pchala/oximite/README.md

# oximite

**oximite** is an asynchronous Rust firmware for the RP2350 (Pimoroni Pico Plus 2 W), designed to retrofit standard domestic espresso machines (such as the Gaggia Classic) with advanced digital controls: dual PID loops (boiler temperature with real-time flow feed-forward, and unified pressure/flow pump profiling), and an embedded web dashboard.

Special thanks to [Pimoroni](https://pimoroni.com) for providing hardware.

Support development by [leaving a tip on Ko-fi](https://ko-fi.com/J5E121FXSB). 



## Getting started

- Repository layout, build, and test commands: [AGENTS.md](AGENTS.md).
- Documentation: [docs/](docs/). Start at [Requirements](docs/requirements.md).
- First-time setup: [Operations](docs/operations.md).

## Disclaimer

All hardware designs, code, and documentation are provided "AS IS", without warranty of any kind.
You are solely responsible for electrical and thermal safety when working with AC mains voltages and pressurized steam boilers.
