pchala/oximite/docs/hardware/mechanics.md

# Mechanics and hydraulic installation

This document describes mounting, enclosure constraints, and hydraulic sensor placement inside domestic espresso machines.

## 1. Electronics mounting and bracket

The controller board mounts inside the chassis using 3D-printable brackets:

- **Material:** PETG, ABS, or ASA. Do NOT use PLA due to elevated temperatures (~60–80 °C) inside the machine casing.
- **Placement:** Position the board in the lower or cooler quadrant of the machine (opposite the boiler exhaust). Ensure air gap from the boiler body.

## 2. Hydraulic sensor integration

```mermaid
flowchart TD
    RES[Water Reservoir] -->|Atmospheric silicone hose| FM[Hall flow meter: GP15]
    FM --> T_IN[Inlet T-fitting]
    T_IN -->|Suction line| PUMP[Vibration pump]
    PUMP --> T_OUT[Outlet T-fitting]
    T_OUT --> PT[Pressure transducer: GP40]
    T_OUT --> OPV[Over-Pressure Valve: OPV]
    OPV -.->|Recirculation bypass| T_IN
    OPV -->|Feed line| BOILER[Boiler & NTC: GP41]
    BOILER --> VALVE[3-way solenoid valve: GP3]
    VALVE -->|Brew path| GROUP[Grouphead / Portafilter puck]
    VALVE -->|Exhaust tube| DRIP[Drip tray]
```

### Flow meter placement

- **Inlet only:** The plastic flow meter (see [BOM](bom.md)) MUST be installed on the low-pressure suction side (between reservoir and pump inlet). Its plastic body cannot withstand pump pressure (up to 15 bar).
- **Air bubbles:** Mount horizontally with nozzle pointing down to prevent trapped air pockets that cause pulse jitter.
- **Recirculation:** The OPV bypass connects back to the pump inlet after the flow meter through an inlet T-fitting. Recirculated water does not affect water volume.

### Pressure transducer placement

- **High-pressure side:** Installed via a metal T-fitting between the pump outlet and the boiler.
- **Thread sealing:** Standard G1/8" thread sealed with food-grade high-temperature thread sealant or bonded copper washer.

## 3. Front panel switch layout

The machine front panel mounts two 3-position momentary mini toggle switches (spring return to center). The center position is off. Mount the power/steam switch on the left and the flush/brew switch on the right. [Hardware pinout](pinout.md) defines the GPIO and function of each switch position.
