pchala/oximite/docs/open-questions.md

# Open questions

This is the single open-question list for the complete system. Use it for project review.

Add each new unresolved question here. Do not keep open-question lists in requirement, design, interface, or component documents. Remove a question only after a requirement or an accepted decision resolves it.

There are currently no open questions.
