pchala/oximite/pcb/oximite.kicad_pcb

## KiCad design pcb/oximite.kicad_pcb (2026-10-21)

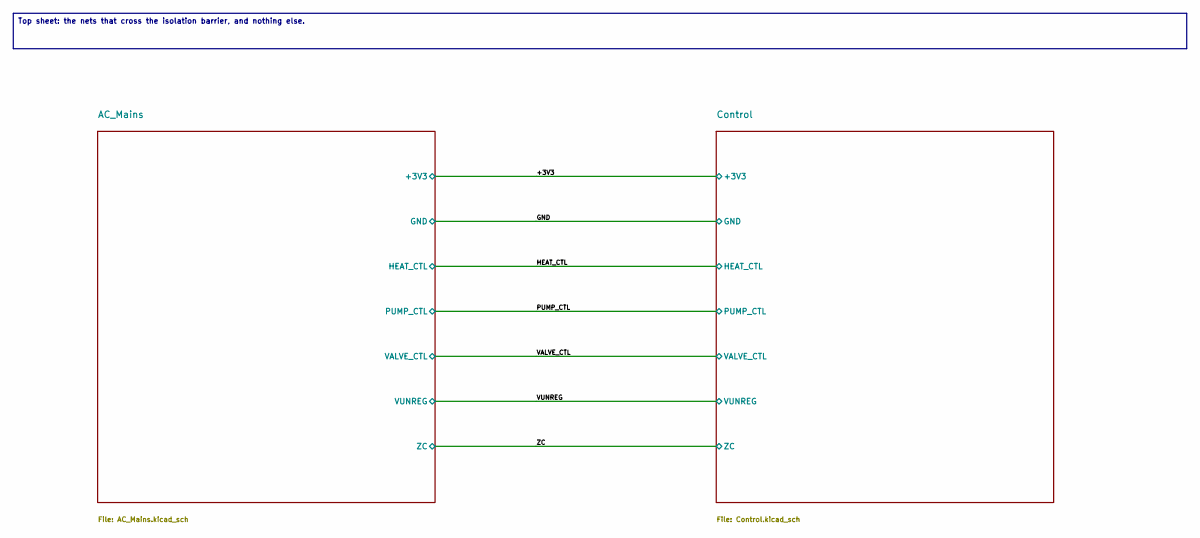
[picture p1: schematic oximite.kicad_sch]

Notes on the sheet:
Top sheet: the nets that cross the isolation barrier, and nothing else.

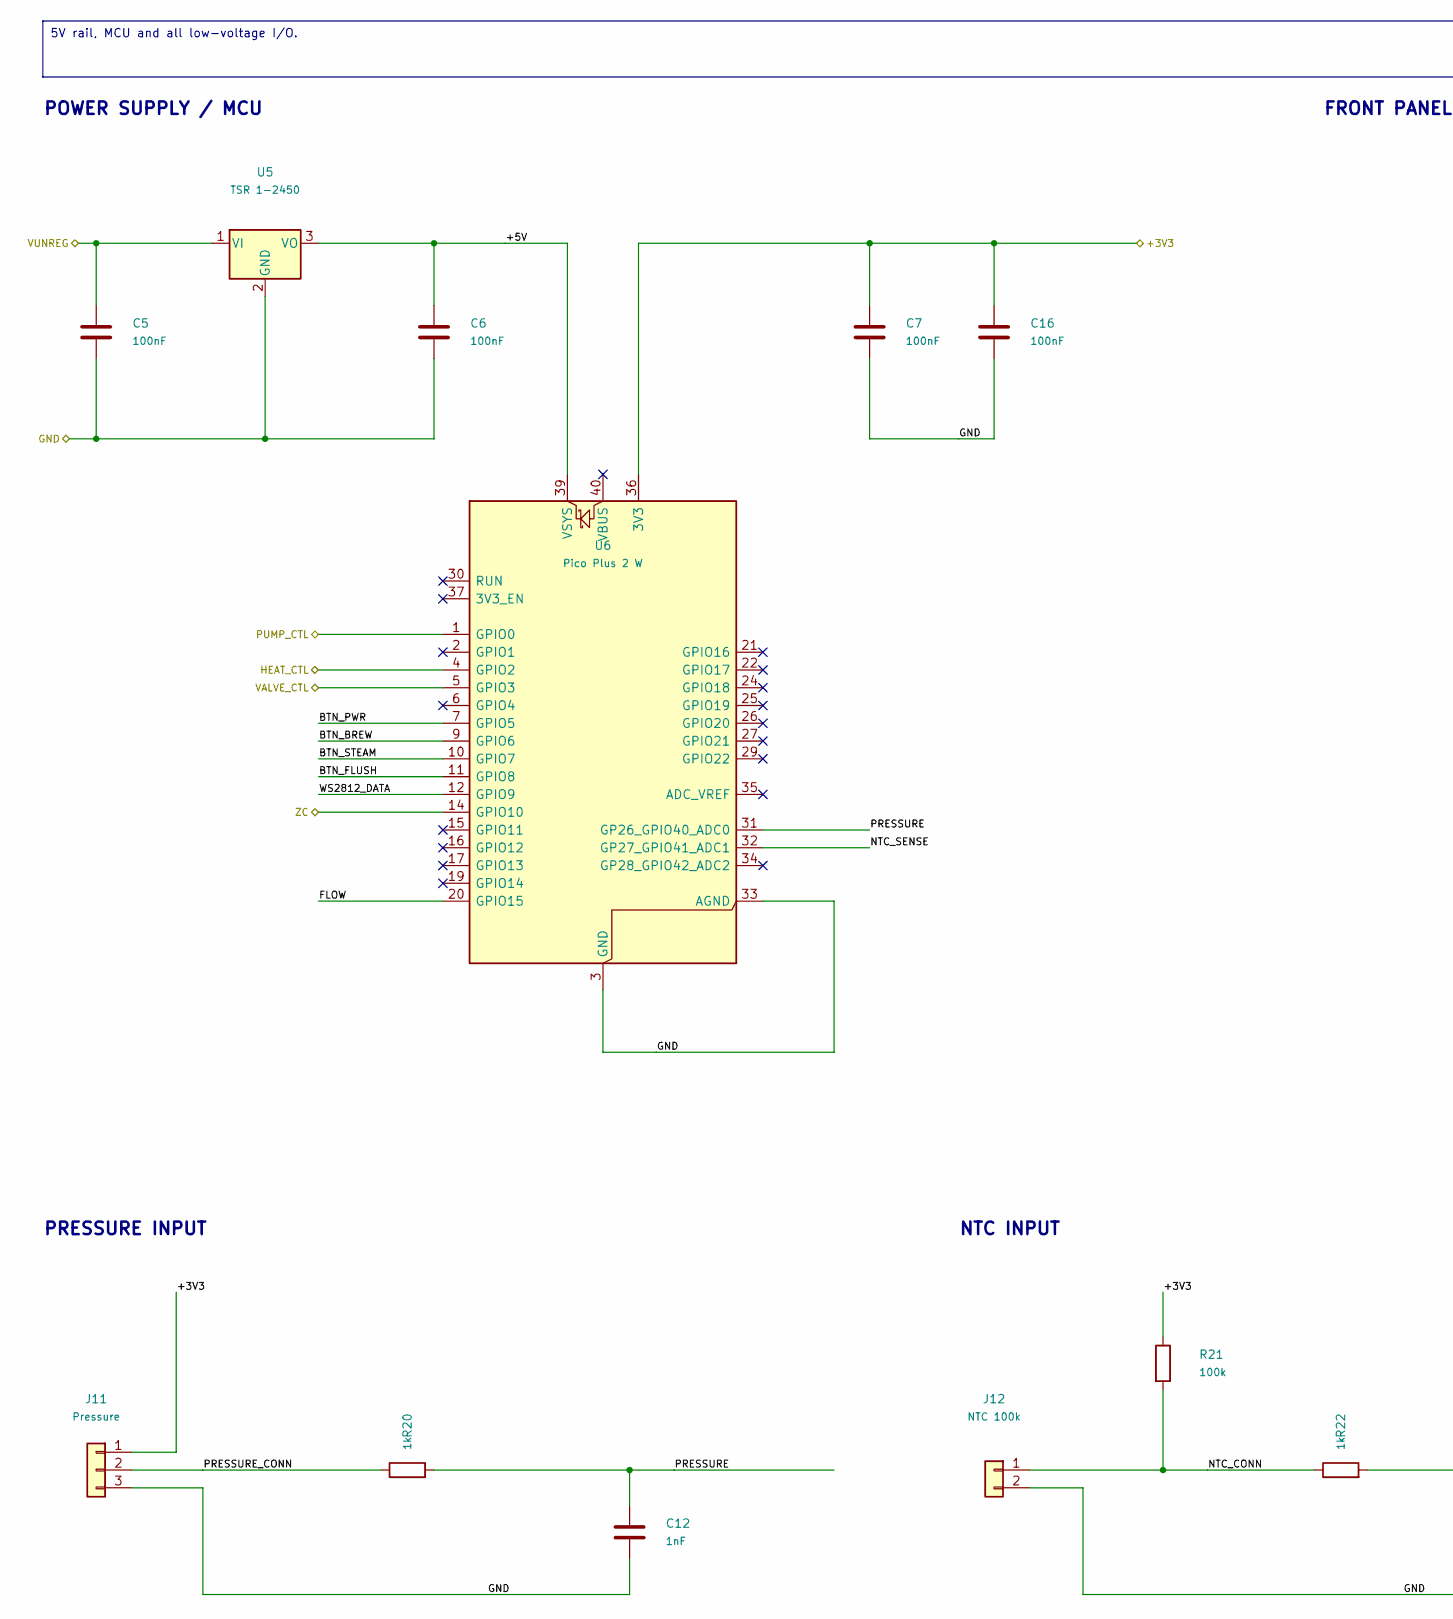
[picture p2: schematic Control.kicad_sch, oximite, part in row 1, column 1]

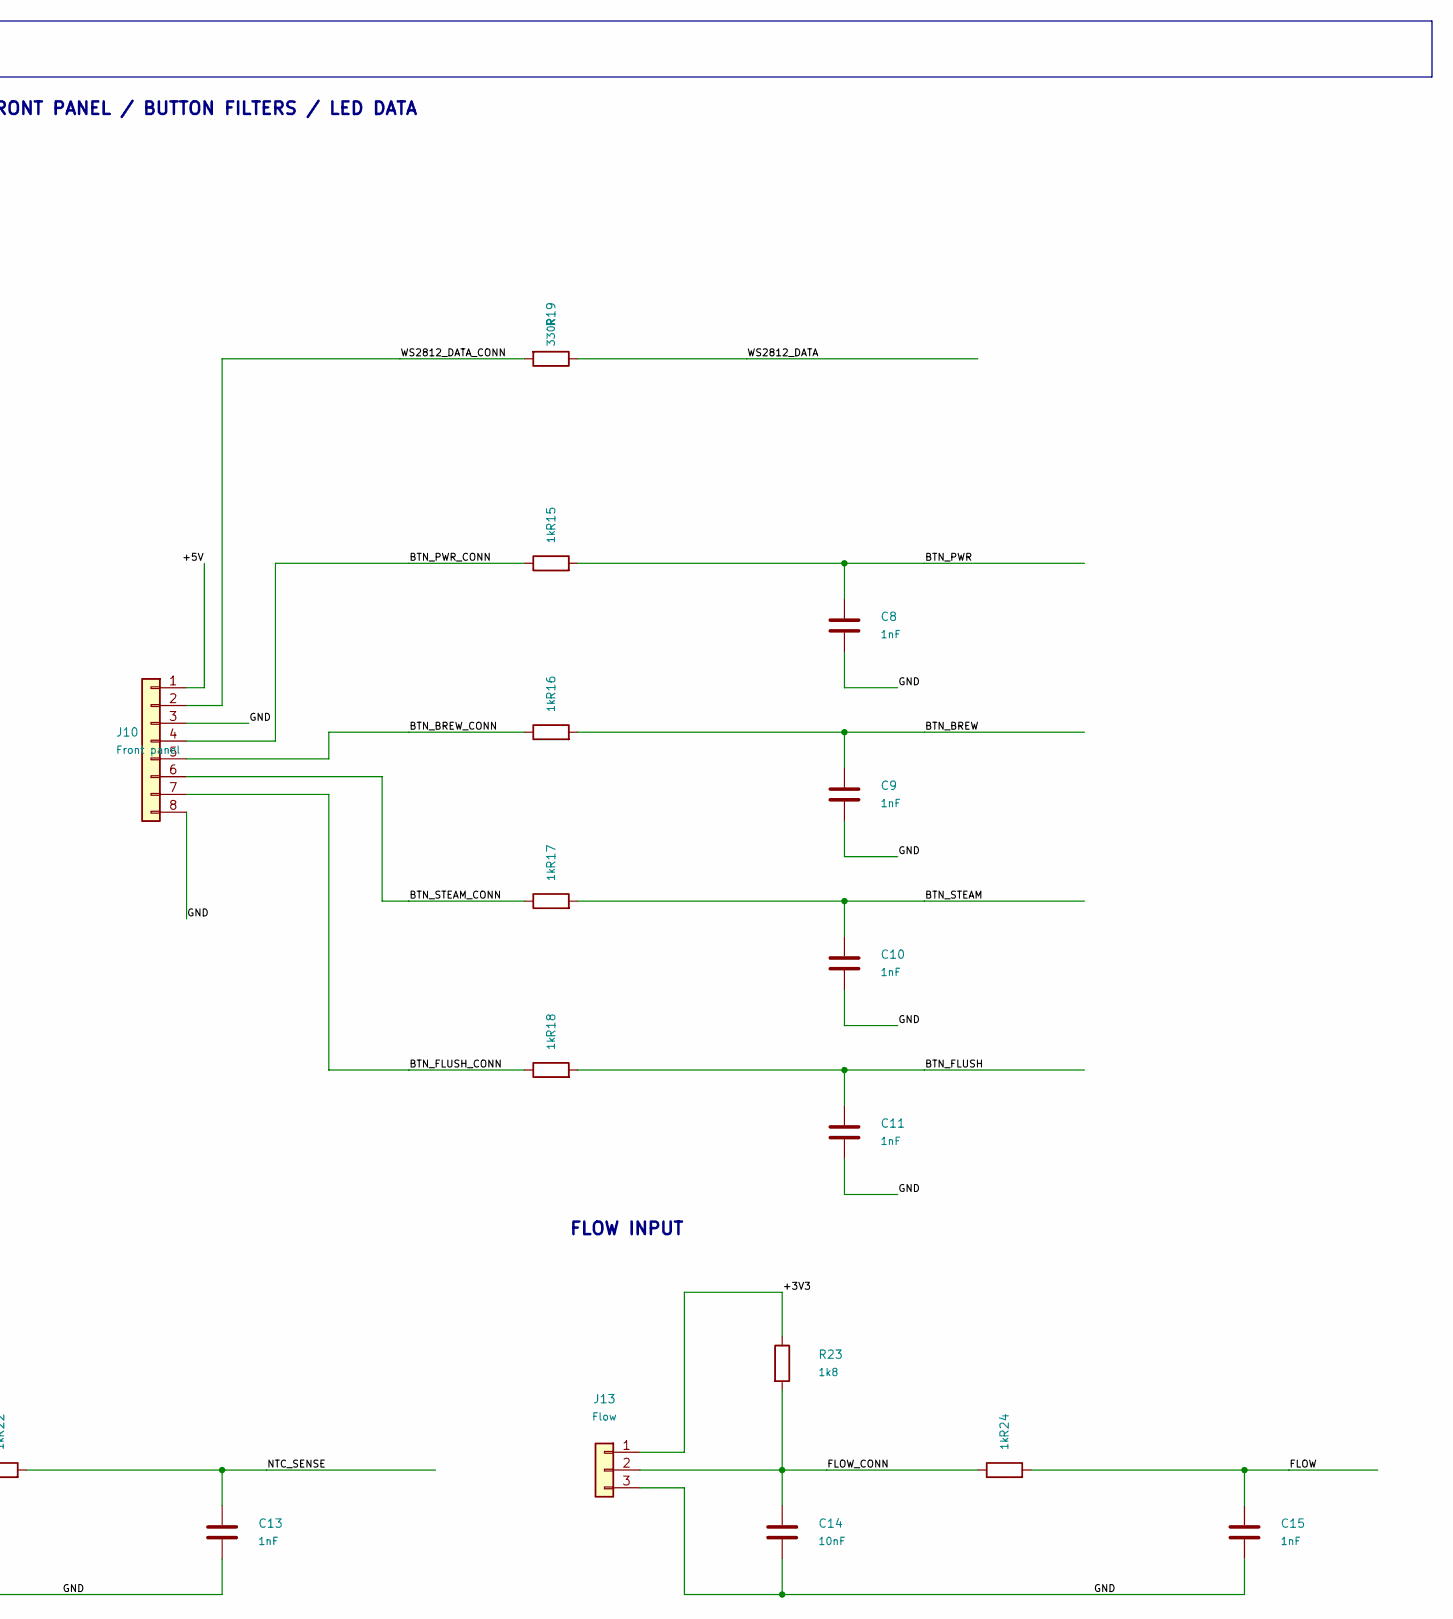
[picture p3: schematic Control.kicad_sch, oximite, part in row 1, column 2]

Parts:
C5, C6, C7, C16: 100nF; C_0603_1608Metric
C8, C9, C10, C11, C12, C13, C15: 1nF; C_0603_1608Metric
C14: 10nF; C_0603_1608Metric
J10: Front panel; JST_XH_B8B-XH-A_1x08_P2.50mm_Vertical
J11: Pressure; JST_XH_B3B-XH-A_1x03_P2.50mm_Vertical
J12: NTC 100k; JST_XH_B2B-XH-A_1x02_P2.50mm_Vertical
J13: Flow; JST_XH_B3B-XH-A_1x03_P2.50mm_Vertical
R15, R16, R17, R18, R20, R22, R24: 1k; R_0603_1608Metric
R19: 330R; R_0603_1608Metric
R21: 100k; R_0603_1608Metric
R23: 1k8; R_0603_1608Metric
U5: TSR 1-2450; Converter_DCDC_TRACO_TSR-1_THT
U6: Pico Plus 2 W; Pimoroni_Pico_Plus_2_W_Header_Mount

Connections:
/+3V3: C7.1, C16.1, J11.1, J13.1, R21.1, R23.1, U6.36 (3V3); also elsewhere on the board
/Control/+5V: C6.1, J10.1, U5.3 (VO), U6.39 (VSYS)
/Control/BTN_BREW: C9.1, R16.2, U6.9 (GPIO6)
/Control/BTN_BREW_CONN: J10.5, R16.1
/Control/BTN_FLUSH: C11.1, R18.2, U6.11 (GPIO8)
/Control/BTN_FLUSH_CONN: J10.7, R18.1
/Control/BTN_PWR: C8.1, R15.2, U6.7 (GPIO5)
/Control/BTN_PWR_CONN: J10.4, R15.1
/Control/BTN_STEAM: C10.1, R17.2, U6.10 (GPIO7)
/Control/BTN_STEAM_CONN: J10.6, R17.1
/Control/FLOW: C15.1, R24.2, U6.20 (GPIO15)
/Control/FLOW_CONN: C14.1, J13.2, R23.2, R24.1
/Control/NTC_CONN: J12.1, R21.2, R22.1
/Control/NTC_SENSE: C13.1, R22.2, U6.32 (GP27_GPIO41_ADC1)
/Control/PRESSURE: C12.1, R20.2, U6.31 (GP26_GPIO40_ADC0)
/Control/PRESSURE_CONN: J11.2, R20.1
/Control/WS2812_DATA: R19.1, U6.12 (GPIO9)
/Control/WS2812_DATA_CONN: J10.2, R19.2
/GND: C5.2, C6.2, C7.2, C8.2, C9.2, C10.2, C11.2, C12.2, C13.2, C14.2, C15.2, C16.2, J10.3, J10.8, J11.3, J12.2, J13.3, U5.2 (GND), U6.3 (GND), U6.8 (GND), U6.13 (GND), U6.18 (GND), U6.23 (GND), U6.28 (GND), U6.33 (AGND), U6.38 (GND); also elsewhere on the board
/HEAT_CTL: U6.4 (GPIO2); also elsewhere on the board
/PUMP_CTL: U6.1 (GPIO0); also elsewhere on the board
/VALVE_CTL: U6.5 (GPIO3); also elsewhere on the board
/VUNREG: C5.1, U5.1 (VI); also elsewhere on the board
/ZC: U6.14 (GPIO10); also elsewhere on the board

Notes on the sheet:
5V rail, MCU and all low-voltage I/O.
POWER SUPPLY / MCU
FRONT PANEL / BUTTON FILTERS / LED DATA
PRESSURE INPUT
NTC INPUT
FLOW INPUT

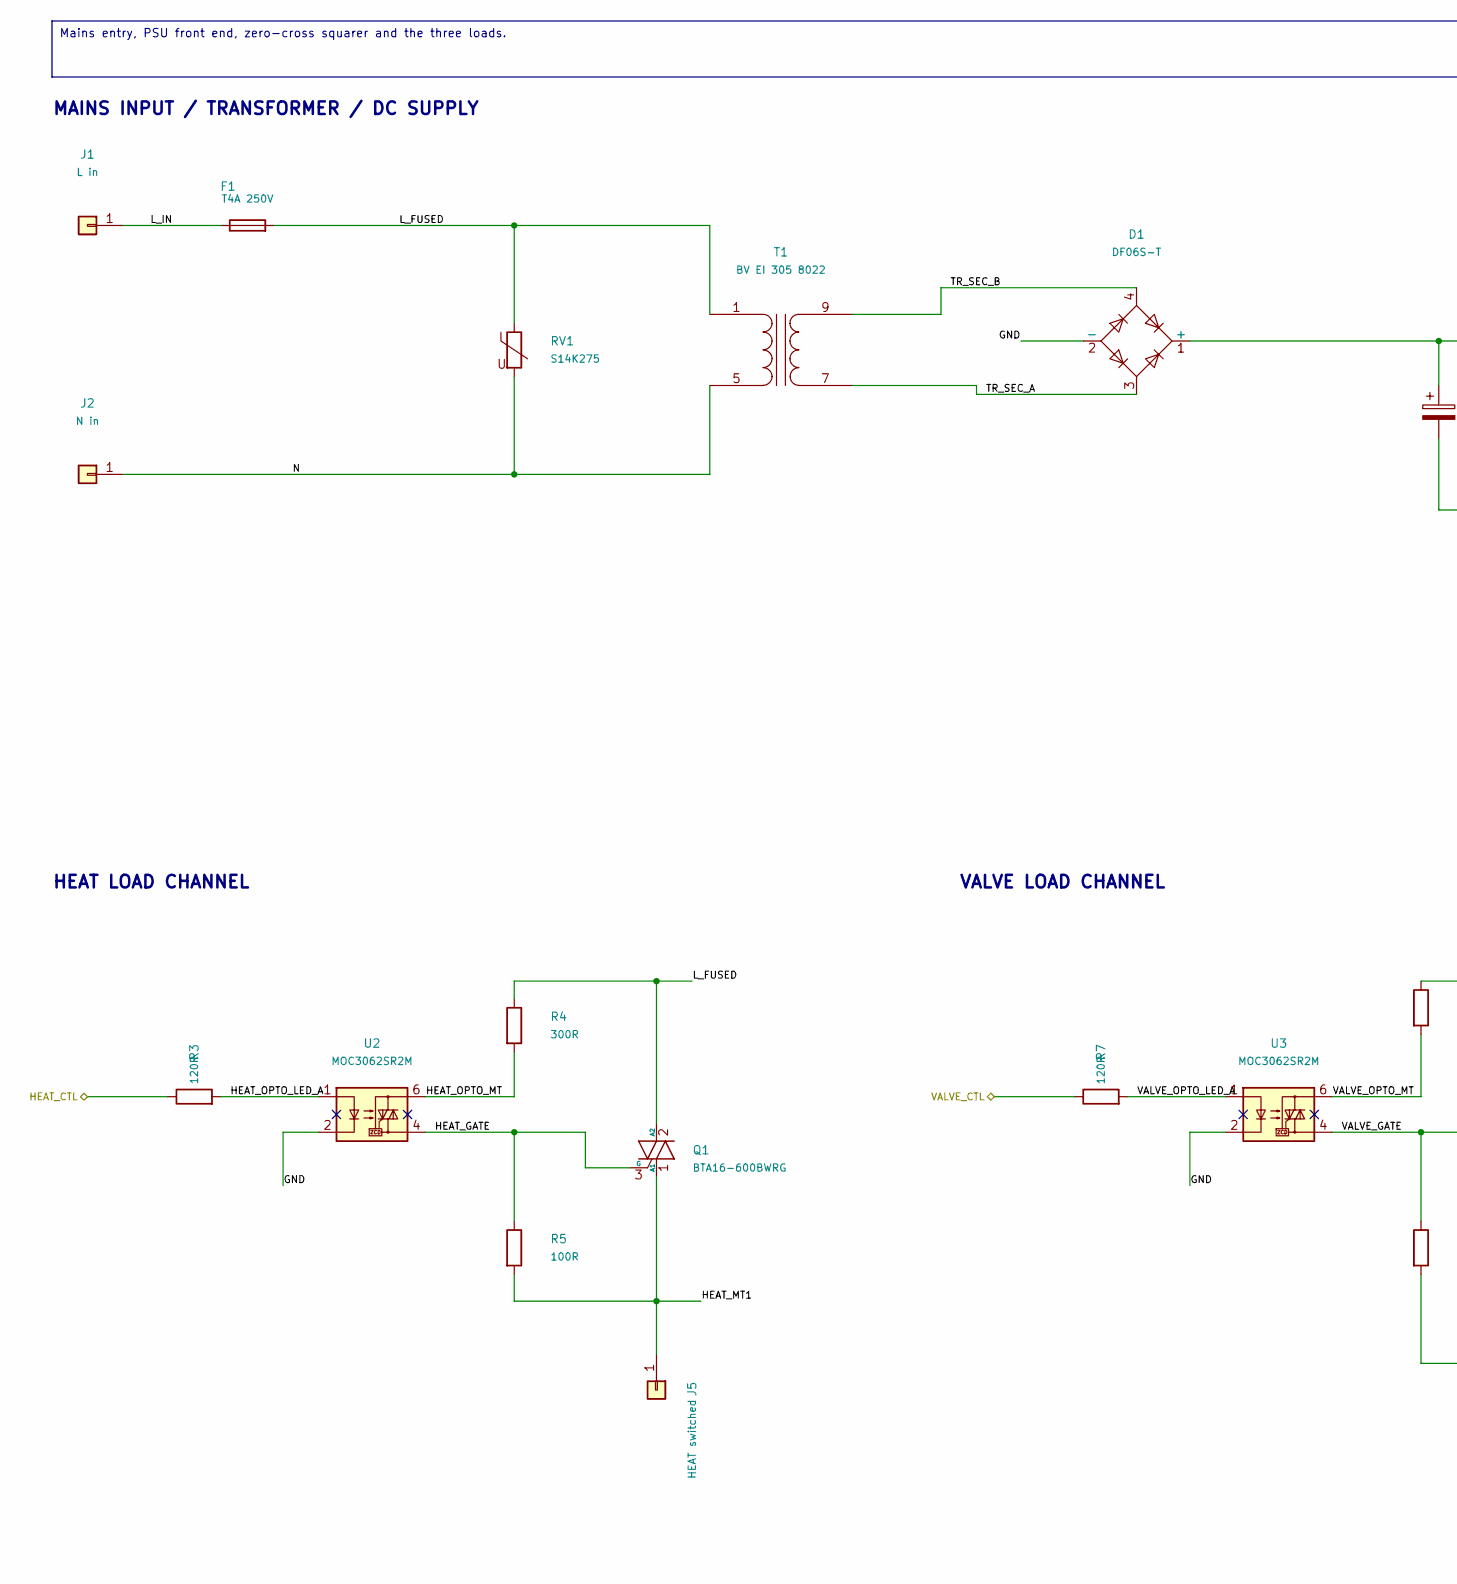
[picture p4: schematic AC_Mains.kicad_sch, oximite, part in row 1, column 1]

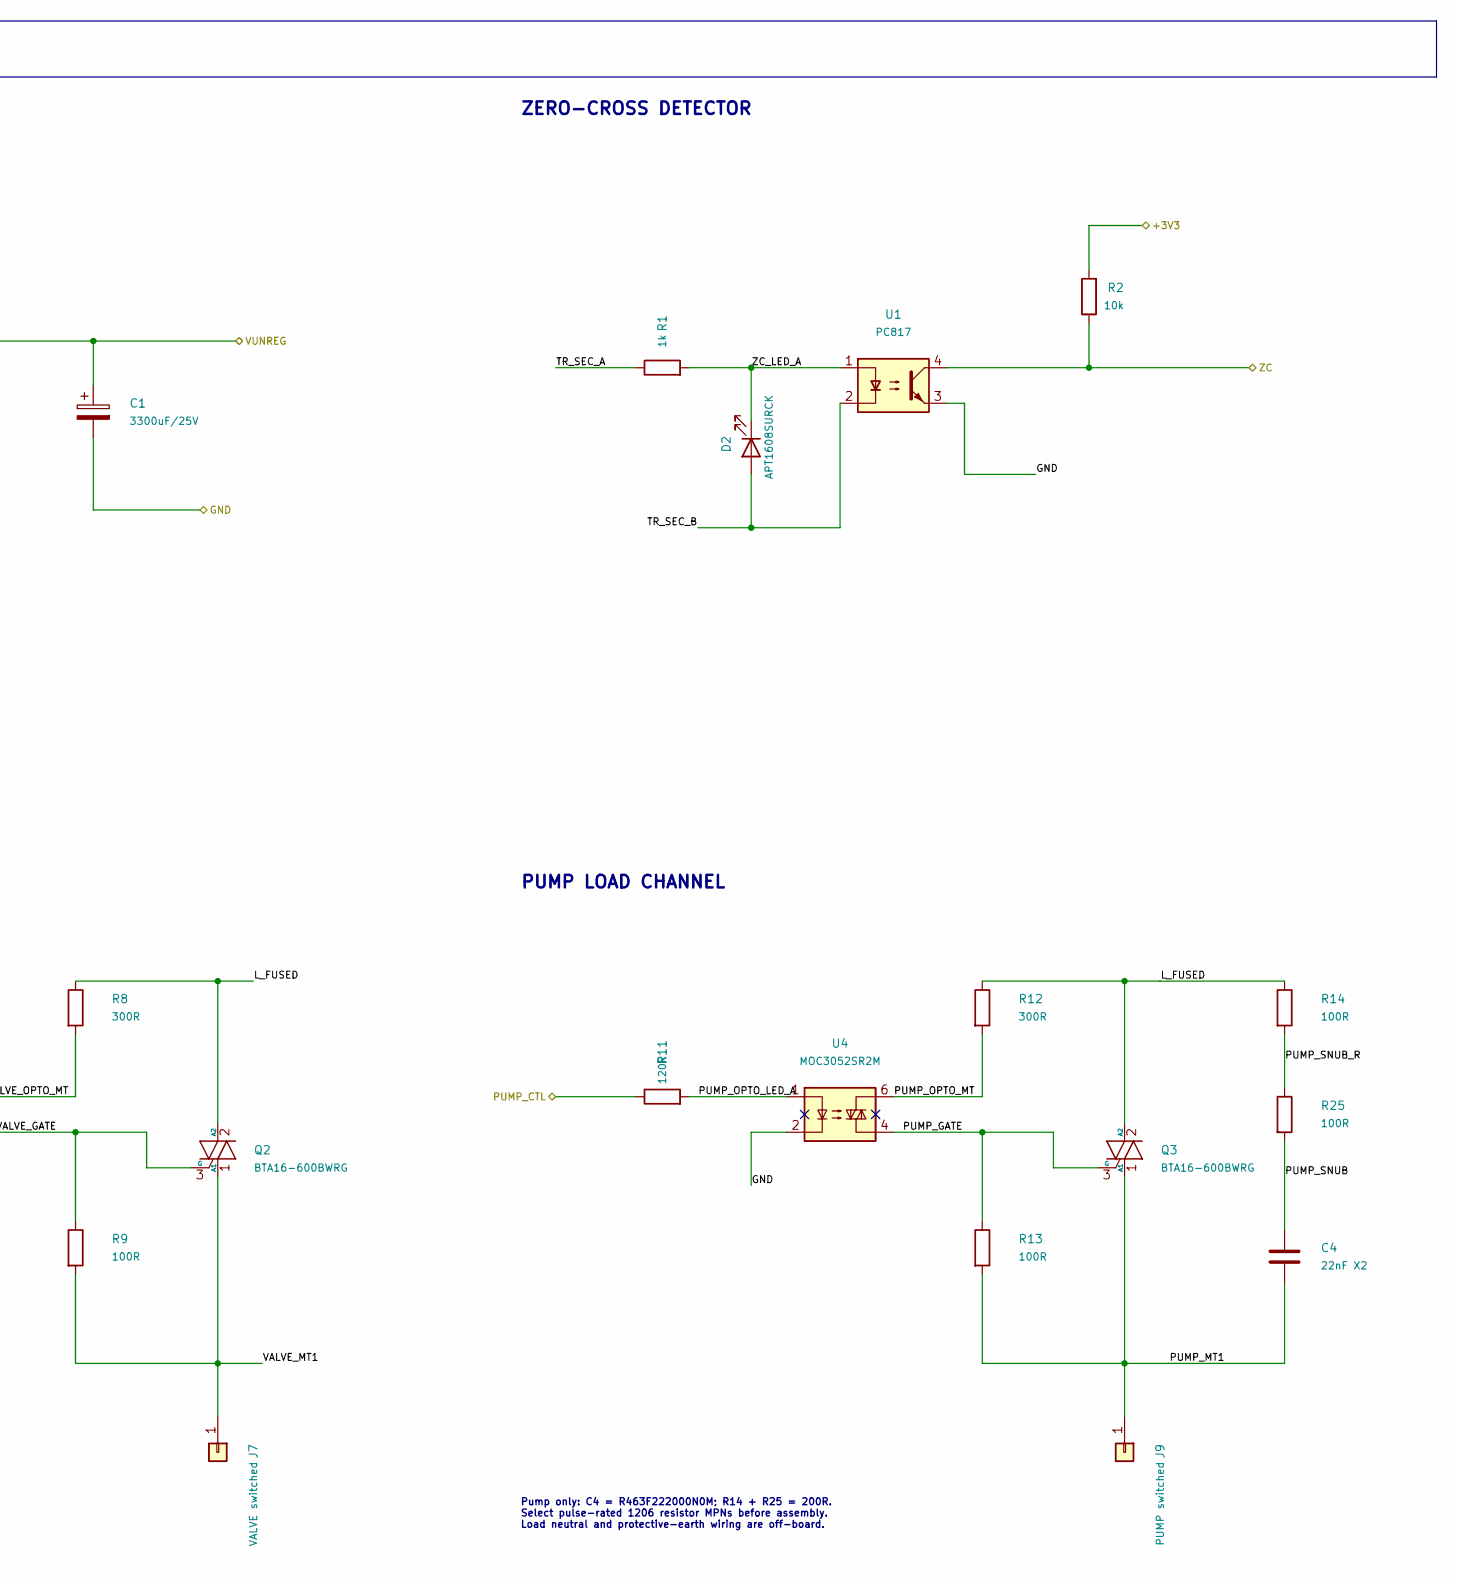
[picture p5: schematic AC_Mains.kicad_sch, oximite, part in row 1, column 2]

Parts:
C1: 3300uF/25V; CP_Radial_D12.5mm_P5.00mm
C4: 22nF X2; C_Rect_L13.0mm_W4.0mm_P10.00mm_FKS3_FKP3_MKS4
D1: DF06S-T; Diode_Bridge_OnSemi_SDIP-4L
D2: APT1608SURCK; LED_0603_1608Metric
F1: T4A 250V; Fuseholder_Clip-5x20mm_Keystone_3517_Inline_P23.11x6.76mm_D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
J1: L in; Spade_6.35mm_Keystone_1287
J2: N in; Spade_6.35mm_Keystone_1287
J5: HEAT switched; Spade_6.35mm_Keystone_1287
J7: VALVE switched; Spade_6.35mm_Keystone_1287
J9: PUMP switched; Spade_6.35mm_Keystone_1287
Q1, Q2, Q3: BTA16-600BWRG; TO-220-3_Vertical
R1: 1k; R_1206_3216Metric
R2: 10k; R_0603_1608Metric
R3, R7, R11: 120R; R_0805_2012Metric
R4, R8, R12: 300R; R_1206_3216Metric
R5, R9, R13, R14, R25: 100R; R_1206_3216Metric
RV1: S14K275; RV_Disc_D16.5mm_W6.7mm_P7.5mm
T1: BV EI 305 8022; Transformer_Hahn_BV_EI_305
U1: PC817; SOP-4_4.4x2.6mm_P1.27mm
U2, U3: MOC3062SR2M; SMDIP-6_W9.53mm_Clearance8mm
U4: MOC3052SR2M; SMDIP-6_W9.53mm_Clearance8mm

Connections:
/+3V3: R2.2; also elsewhere on the board
/AC_Mains/HEAT_GATE: Q1.3 (G), R5.1, U2.4
/AC_Mains/HEAT_MT1: J5.1, Q1.1 (A1), R5.2
/AC_Mains/HEAT_OPTO_LED_A: R3.2, U2.1
/AC_Mains/HEAT_OPTO_MT: R4.2, U2.6
/AC_Mains/L_FUSED: F1.2, Q1.2 (A2), Q2.2 (A2), Q3.2 (A2), R4.1, R8.1, R12.1, R14.1, RV1.1, T1.1
/AC_Mains/L_IN: F1.1, J1.1
/AC_Mains/N: J2.1, RV1.2, T1.5 (P2)
/AC_Mains/PUMP_GATE: Q3.3 (G), R13.1, U4.4
/AC_Mains/PUMP_MT1: C4.2, J9.1, Q3.1 (A1), R13.2
/AC_Mains/PUMP_OPTO_LED_A: R11.2, U4.1
/AC_Mains/PUMP_OPTO_MT: R12.2, U4.6
/AC_Mains/PUMP_SNUB: C4.1, R25.2
/AC_Mains/PUMP_SNUB_R: R14.2, R25.1
/AC_Mains/TR_SEC_A: D1.3, R1.1, T1.7 (S1)
/AC_Mains/TR_SEC_B: D1.4, D2.2 (A), T1.9 (S2), U1.2
/AC_Mains/VALVE_GATE: Q2.3 (G), R9.1, U3.4
/AC_Mains/VALVE_MT1: J7.1, Q2.1 (A1), R9.2
/AC_Mains/VALVE_OPTO_LED_A: R7.2, U3.1
/AC_Mains/VALVE_OPTO_MT: R8.2, U3.6
/AC_Mains/ZC_LED_A: D2.1 (K), R1.2, U1.1
/GND: C1.2, D1.2 (-), U1.3, U2.2, U3.2, U4.2; also elsewhere on the board
/HEAT_CTL: R3.1; also elsewhere on the board
/PUMP_CTL: R11.1; also elsewhere on the board
/VALVE_CTL: R7.1; also elsewhere on the board
/VUNREG: C1.1, D1.1 (+); also elsewhere on the board
/ZC: R2.1, U1.4; also elsewhere on the board

Notes on the sheet:
VALVE LOAD CHANNEL
PUMP LOAD CHANNEL
HEAT LOAD CHANNEL
MAINS INPUT / TRANSFORMER / DC SUPPLY
ZERO-CROSS DETECTOR
Mains entry, PSU front end, zero-cross squarer and the three loads.
Pump only: C4 = R463F222000N0M; R14 + R25 = 200R. Select pulse-rated 1206 resistor MPNs before assembly. Load neutral and protective-earth wiring are off-board.

Board: 2 copper layers, 64 parts (1 on the bottom side), 44 nets, no tracks yet.

Other parts of the board:
H1, H2, H3, H4: M3 corner mounting; MountingHole_3.2mm_M3
