pchala/oximite/src/state.rs

use core::cell::Cell;
use core::sync::atomic::Ordering;
use embassy_sync::blocking_mutex::raw::CriticalSectionRawMutex;
use embassy_sync::blocking_mutex::Mutex as BlockingMutex;
use embassy_sync::channel::Channel;
use embassy_sync::watch::Watch;
use num_enum::{IntoPrimitive, TryFromPrimitive};
use portable_atomic::{AtomicU32, AtomicU8};

/// Discriminants are a wire contract with the web UI: `web_api` sends the raw
/// value as telemetry `st`, and `index.html` indexes a positional name array
/// with it. The HTML is gzipped into the firmware by `build.rs` and the value
/// is never persisted to flash, so the two always ship together — but renumber
/// both sides in the same commit.
#[repr(u8)]
#[derive(Clone, Copy, PartialEq, defmt::Format, IntoPrimitive, TryFromPrimitive)]
pub enum MachineState {
    Idle = 0,
    Brewing = 1,
    Steaming = 2,
    Sleeping = 3,
    Pumping = 4,
    Cooling = 5,
    HotWater = 6,
}

impl MachineState {
    /// States representing an active hardware operation (profile/steam/pump
    /// running). The coordinator treats this as "an operation is in flight",
    /// so any command that isn't one of `Steaming`'s two onward transitions
    /// stops the machine. Update this in one place when adding new states.
    pub fn is_busy(self) -> bool {
        matches!(
            self,
            MachineState::Brewing
                | MachineState::Pumping
                | MachineState::Cooling
                | MachineState::HotWater
                | MachineState::Steaming
        )
    }
}

#[derive(Clone)]
#[allow(clippy::large_enum_variant)]
pub enum MachineCommand {
    RunProfile(crate::profiles::BrewProfile),
    Brew,
    Stop,
    Steam,
    Flush,
    DirectPump(f32),
    SaveMachine(crate::settings::MachineSettings),
    SavePids(crate::settings::PidSettings, crate::settings::PidSettings),
    SaveWifi(crate::settings::WifiSettings),
    /// Store a profile in `slot`, mirroring it to flash. Routed through the
    /// coordinator rather than signalled straight to the flash task so it is
    /// held back during a shot like every other flash write.
    SaveProfile(u8, crate::profiles::BrewProfile),
    DeleteProfile(u8),
    TogglePower,
    SetSessionTemp(f32),
}

/// How the coordinator should treat a command before the state machine sees
/// it. See [`MachineCommand::ambient`].
#[derive(PartialEq, Eq, Clone, Copy)]
pub enum Ambient {
    /// Carries a machine action: goes to the transition table.
    No,
    /// Applies immediately in any state, touching RAM only.
    RamOnly,
    RamAndFlash,
}

impl MachineCommand {
    /// Whether this command bypasses the state machine, and if so whether it
    /// reaches flash.
    pub fn ambient(&self) -> Ambient {
        match self {
            MachineCommand::SaveMachine(_)
            | MachineCommand::SavePids(_, _)
            | MachineCommand::SaveWifi(_)
            | MachineCommand::SaveProfile(_, _)
            | MachineCommand::DeleteProfile(_) => Ambient::RamAndFlash,

            MachineCommand::SetSessionTemp(_) => Ambient::RamOnly,

            MachineCommand::RunProfile(_)
            | MachineCommand::Brew
            | MachineCommand::Stop
            | MachineCommand::Steam
            | MachineCommand::Flush
            | MachineCommand::DirectPump(_)
            | MachineCommand::TogglePower => Ambient::No,
        }
    }
}

impl defmt::Format for MachineCommand {
    fn format(&self, fmt: defmt::Formatter) {
        match self {
            MachineCommand::RunProfile(_) => defmt::write!(fmt, "RunProfile"),
            MachineCommand::Brew => defmt::write!(fmt, "Brew"),
            MachineCommand::Stop => defmt::write!(fmt, "Stop"),
            MachineCommand::Steam => defmt::write!(fmt, "Steam"),
            MachineCommand::Flush => defmt::write!(fmt, "Flush"),
            MachineCommand::DirectPump(p) => defmt::write!(fmt, "DirectPump({})", p),
            MachineCommand::SaveMachine(_) => defmt::write!(fmt, "SaveMachine"),
            MachineCommand::SavePids(_, _) => defmt::write!(fmt, "SavePids"),
            MachineCommand::SaveWifi(_) => defmt::write!(fmt, "SaveWifi"),
            MachineCommand::SaveProfile(slot, _) => defmt::write!(fmt, "SaveProfile({})", slot),
            MachineCommand::DeleteProfile(slot) => defmt::write!(fmt, "DeleteProfile({})", slot),
            MachineCommand::TogglePower => defmt::write!(fmt, "TogglePower"),
            MachineCommand::SetSessionTemp(t) => defmt::write!(fmt, "SetSessionTemp({})", t),
        }
    }
}

/// Commands headed for `coordinator::coordinator_task`.
///
/// This is a queue, not a `Signal`, because it has several independent
/// producers — the button task on core0 and the web API on core1 — and every
/// one of their commands means something different. A `Signal` holds a single
/// slot and overwrites it, so two commands issued before the coordinator was
/// scheduled would silently collapse into one, and a genuinely concurrent
/// core1 request could destroy a button press outright. Ordering matters too:
/// a `Stop` followed by a start command must arrive as two separate events.
///
/// Depth 4 covers the realistic worst case — all four buttons resolving in one
/// debounce pass — without spending much RAM on the large `RunProfile` variant.
static COMMAND_QUEUE: Channel<CriticalSectionRawMutex, MachineCommand, 4> = Channel::new();

/// Next ack ticket.
///
/// Bumped inside the same critical section as the push because tickets are only
/// meaningful in queue order, and both cores produce commands: the button task
/// on core0 and the web tasks on core1.
static NEXT_TICKET: BlockingMutex<CriticalSectionRawMutex, Cell<u32>> =
    BlockingMutex::new(Cell::new(0));

/// Commands the coordinator has finished serving. Tickets start at 1, so 0
/// means nothing has been served yet and ticket N is applied once this reaches N.
static SERVED: AtomicU32 = AtomicU32::new(0);

/// Queues a command, returning its ack ticket, or `None` if the queue is full.
///
/// Non-blocking, because the callers are the button poller and HTTP request
/// handlers and neither may stall on the coordinator. The ticket is what makes
/// that safe: a caller who needs to know the command was acted on watches
/// [`get_ack`] reach it, and a `None` means the command never made it.
#[must_use = "a dropped ticket cannot be confirmed; use `let _ =` if the caller does not need one"]
pub fn send_command(cmd: MachineCommand) -> Option<u32> {
    NEXT_TICKET.lock(|t| {
        if COMMAND_QUEUE.try_send(cmd).is_err() {
            defmt::warn!("Command queue full — command dropped");
            return None;
        }
        let ticket = t.get().wrapping_add(1);
        t.set(ticket);
        Some(ticket)
    })
}

/// Records that the coordinator finished serving one command. Coordinator only.
pub fn mark_served() {
    SERVED.fetch_add(1, Ordering::Relaxed);
}

/// Highest ticket the coordinator has served.
pub fn get_ack() -> u32 {
    SERVED.load(Ordering::Relaxed)
}

/// Waits for the next queued command. Single-consumer: only the coordinator
/// calls this.
pub async fn next_command() -> MachineCommand {
    COMMAND_QUEUE.receive().await
}

/// Filtered analog readings, published by `adc::adc_task`.
#[derive(Clone, Copy)]
pub struct SensorReading {
    pub pressure_bar: f32,
    pub temp_c: f32,
}

impl Default for SensorReading {
    fn default() -> Self {
        // Not derived: a 0 °C boiler is a huge error to the temperature PID,
        // and this default is what the control loop reads on the first ticks
        // after boot, before the ADC has published anything.
        Self {
            pressure_bar: 0.0,
            temp_c: 20.0,
        }
    }
}

pub static SENSOR_WATCH: Watch<CriticalSectionRawMutex, SensorReading, 4> = Watch::new();

/// The latest filtered sensor reading, or a plausible cold-machine reading if
/// the ADC has not published yet.
pub fn get_sensors() -> SensorReading {
    SENSOR_WATCH.try_get().unwrap_or_default()
}

/// Everything the UI and the LED task need to render the machine, published
/// as one snapshot by `control::ac_sync_control_task`, once per 50 Hz control
/// tick. Single producer: the measured values are copied in from
/// `SENSOR_WATCH` rather than written by the ADC task directly, so every field
/// in a given snapshot describes the same tick.
#[derive(Clone, Copy, Default)]
pub struct Telemetry {
    /// Control-loop tick this snapshot describes. Lets a consumer tell a
    /// duplicate sample from a fresh one, and count frames it never saw.
    pub tick: u32,
    pub pressure_bar: f32,
    pub temp_c: f32,
    /// Setpoint the profile asked for, 0 when the step names no pressure
    /// target.
    pub target_bar: f32,
    pub target_temp: f32,
    /// `target_temp` plus the brew-flow feed-forward — what the temperature PID
    /// actually chased. Diverges from `target_temp` by several degrees during a
    /// shot, which otherwise reads as unexplained overshoot.
    pub effective_target_temp: f32,
    pub target_ml_s: f32,
    /// Flow reading the controller acted on this tick. Carried here so a log
    /// row is one coherent snapshot; the web task runs on the other core and
    /// would otherwise sample flow at a different instant than pressure.
    pub flow_rate_ml_s: f32,
    /// Shot volume as of this tick, for the same reason.
    pub volume_ml: f32,
    /// True while the flow channel is the binding constraint on the pump — the
    /// unified controller picked flow over pressure. Without it a log can't
    /// tell a flow-controlled step from a pressure step that happens to be
    /// flowing.
    pub flow_controlled: bool,
    pub heater_duty: f32,
    /// Triac duty the pump was driven at this tick, 0-100.
    pub pump_duty: f32,
}

impl Telemetry {
    /// Group-head temperature for display: the measured boiler value with the
    /// boiler-to-group offset subtracted, except while steaming, where the
    /// boiler value *is* what the UI shows.
    pub fn display_temp(&self, offset: f32, is_steaming: bool) -> f32 {
        if is_steaming {
            self.temp_c
        } else {
            self.temp_c - offset
        }
    }
}

pub static TELEMETRY_WATCH: Watch<CriticalSectionRawMutex, Telemetry, 4> = Watch::new();

/// The latest telemetry snapshot, or a plausible cold-machine reading if no
/// producer has published yet — callers would otherwise see a 0 °C boiler for
/// the first few milliseconds after boot and act on it.
pub fn get_telemetry() -> Telemetry {
    TELEMETRY_WATCH.try_get().unwrap_or(Telemetry {
        temp_c: 20.0,
        target_temp: 20.0,
        effective_target_temp: 20.0,
        ..Default::default()
    })
}

// The Watch channel acts as our centralized, broadcasted state for tasks that want notifications.
pub static MACHINE_STATE: Watch<CriticalSectionRawMutex, MachineState, 4> = Watch::new();
static CURRENT_STATE: AtomicU8 = AtomicU8::new(MachineState::Idle as u8);

pub fn get_state() -> MachineState {
    // The raw value is only ever written via set_state(), so it always
    // matches a valid discriminant; Idle is a safe fallback regardless.
    MachineState::try_from_primitive(CURRENT_STATE.load(Ordering::Relaxed))
        .unwrap_or(MachineState::Idle)
}

pub fn set_state(state: MachineState) {
    let old_state = get_state();
    if old_state != state {
        defmt::info!("State Change: {:?} -> {:?}", old_state, state);
        CURRENT_STATE.store(state.into(), Ordering::Relaxed);
        MACHINE_STATE.sender().send(state);
    }
}

static SESSION_BREW_TEMP: AtomicU32 = AtomicU32::new(0);

pub fn get_session_brew_temp() -> f32 {
    f32::from_bits(SESSION_BREW_TEMP.load(Ordering::Relaxed))
}

pub fn set_session_brew_temp(temp: f32) {
    SESSION_BREW_TEMP.store(temp.to_bits(), Ordering::Relaxed);
}
