pchala/oximite/src/adc.rs

//! Analog sensor acquisition: oversamples the pressure and boiler-temperature
//! channels, filters them, converts to physical units, and publishes the
//! result into `state::SENSOR_WATCH` for every other task to read.

use embassy_rp::adc::{Adc, Async, Channel};
use embassy_time::Duration;

use crate::state::{SensorReading, SENSOR_WATCH};

/// Conversions taken per channel per cycle, and how many of the trailing ones
/// are averaged. The leading `SAMPLE_TOTAL - SAMPLE_KEEP` are thrown away to
/// let the sample-and-hold capacitor settle.
const SAMPLE_TOTAL: usize = 10;
const SAMPLE_KEEP: usize = 5;

/// Raw ADC counts to boiler temperature in °C, by linear interpolation between
/// the two `NTC_LUT` entries that bracket the reading.
fn get_temp_from_adc(raw_adc: f32) -> f32 {
    let index_f = raw_adc.clamp(0.0, 4095.0) / 4.0;
    let index = index_f as usize;

    if index >= 1024 {
        return NTC_LUT[1024];
    }

    let remainder = index_f - (index as f32);
    let lower = NTC_LUT[index];
    let upper = NTC_LUT[index + 1];
    lower + (upper - lower) * remainder
}

/// Raw ADC counts to gauge pressure in bar. The transducer outputs 0.4 V at
/// 0 MPa and 2.4 V at 1.2 MPa (12 bar), i.e. 6 bar per volt above a 0.4 V
/// offset. Clamped at zero so sensor noise around ambient can't read negative.
fn get_pressure_from_adc(raw_adc: f32) -> f32 {
    const ADC_TO_VOLTS: f32 = 3.3 / 4095.0;
    const V_AT_ZERO_BAR: f32 = 0.4;
    const BAR_PER_VOLT: f32 = 12.0 / 2.0;
    ((raw_adc * ADC_TO_VOLTS - V_AT_ZERO_BAR) * BAR_PER_VOLT).max(0.0)
}

/// Samples `SAMPLE_TOTAL` conversions from `ch`, discarding the leading ones
/// (letting the sample-and-hold cap settle) and returning the average of the
/// last `SAMPLE_KEEP`.
async fn sample_avg(adc: &mut Adc<'static, Async>, ch: &mut Channel<'static>) -> f32 {
    let discard = SAMPLE_TOTAL - SAMPLE_KEEP;
    let mut sum: u32 = 0;
    for i in 0..SAMPLE_TOTAL {
        let v = adc.read(ch).await.unwrap_or(0) as u32;
        if i >= discard {
            sum += v;
        }
    }
    sum as f32 / SAMPLE_KEEP as f32
}

#[embassy_executor::task]
pub async fn adc_task(
    mut adc: Adc<'static, Async>,
    mut ch_p: Channel<'static>,
    mut ch_t: Channel<'static>,
) {
    let mut t_ema = 0.0f32;
    let mut initialized = false;

    const P_WINDOW: usize = 10;
    let mut p_buffer = [0.0f32; P_WINDOW];
    let mut p_index = 0;
    let mut p_sum = 0.0f32;

    let mut ticker = embassy_time::Ticker::every(Duration::from_hz(500));

    loop {
        // Discard the first `SAMPLE_TOTAL - SAMPLE_KEEP` samples to allow the ADC
        // sample-and-hold capacitor to fully charge through the 1k series resistor on the analog
        // lines, then average the rest to knock down noise before the EMA filter.
        let raw_p = sample_avg(&mut adc, &mut ch_p).await;
        let raw_t = sample_avg(&mut adc, &mut ch_t).await;

        if !initialized {
            p_buffer = [raw_p; P_WINDOW];
            p_sum = raw_p * P_WINDOW as f32;
            t_ema = raw_t;
            initialized = true;
        } else {
            // --- Pressure: Boxcar Filter (SMA) ---
            p_sum -= p_buffer[p_index];
            p_buffer[p_index] = raw_p;
            p_sum += raw_p;
            p_index = (p_index + 1) % P_WINDOW;

            // --- Temperature: Keep the EMA ---
            const ALPHA_T: f32 = 0.2; // ~20.0 Hz Cutoff
            t_ema += ALPHA_T * (raw_t - t_ema);
        }

        let p_mean_raw = p_sum / P_WINDOW as f32;

        let p_bar = get_pressure_from_adc(p_mean_raw);
        let t_c = get_temp_from_adc(t_ema);

        SENSOR_WATCH.sender().send(SensorReading {
            pressure_bar: p_bar,
            temp_c: t_c,
        });

        ticker.next().await;
    }
}

/// Boiler temperature in C at each of the 1025 quarter-scale ADC steps, so
/// index `n` corresponds to a raw reading of `n * 4`.
const NTC_LUT: [f32; 1025] = [
    300.00, 300.00, 300.00, 300.00, 300.00, 300.00, 300.00, 300.00, 300.00, 295.09, 287.69, 281.17,
    275.29, 270.04, 265.21, 260.83, 256.78, 253.01, 249.51, 246.22, 243.16, 240.27, 237.53, 234.94,
    232.50, 230.15, 227.92, 225.80, 223.77, 221.81, 219.95, 218.14, 216.41, 214.74, 213.13, 211.58,
    210.08, 208.62, 207.21, 205.84, 204.52, 203.23, 201.98, 200.76, 199.57, 198.42, 197.29, 196.19,
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
    89.40, 89.29, 89.17, 89.05, 88.93, 88.81, 88.69, 88.57, 88.45, 88.34, 88.22, 88.10, 87.98,
    87.86, 87.75, 87.63, 87.51, 87.39, 87.28, 87.16, 87.04, 86.92, 86.81, 86.69, 86.57, 86.46,
    86.34, 86.22, 86.11, 85.99, 85.87, 85.76, 85.64, 85.53, 85.41, 85.30, 85.18, 85.07, 84.95,
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
];
