pchala/oximite/(commit log)

2026-07-01 Last FW for RP2040
    * some fixes
    * flow control cleanup
    * cleanup wifi
    * cleanup html
    * wifi simplification - flash update rename
    * fix valve in Descale
    * some cleanup
    * align on pump power
    * make proper descaling
    * try to move irq to core1
    * fix(wifi): Wait for link to become up before monitoring for disconnections
    * Revert "try to move irq to core1"
    This reverts commit eb24547670758d0c11ab4984887a8a5b8ace19c0.
    * core1 workaround
    [buttons.rs, control.rs, flow_meter.rs, main.rs, settings.rs, state.rs, wifi_task.rs]
2026-07-08 Pimoroni plus2w initial version
    * port to pico2
    * add How water mode and filter more pressure readings
    * handle settings better
    * wrap solenoid
    * finish porting to Pico2
    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
    [build.rs, control.rs, coordinator.rs, flow_meter.rs, leds.rs, main.rs, settings.rs, state.rs]
2026-08-22 Dev2 (#3)
    * simplify PID
    * simplify
    * flow control fix
    * freeze PID during brew
    * perfect feed forward implementation
    * some extra features + fixes
    * improve setting handling
    * fix test
    * fix UI
    * fix telemetry
    * use PIO for heater as well
    * remove usage persistence
    * Switch back flow control to proportional
    * Switch back flow control to proportional
    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
    [adc.rs, board.rs, buttons.rs, control.rs, coordinator.rs, cyw43_nvram.rs, dhcp.rs]
2026-08-24 unified pid
2026-08-26 use boxcar for pressure
2026-08-27 test unified pid
2026-08-28 refactor flow
2026-08-28 remove flow pid
